cliffanet/car/doc/fwburn/README.md

# Обновление прошивки

Неодходимое оборудование:

- SWD-кабель

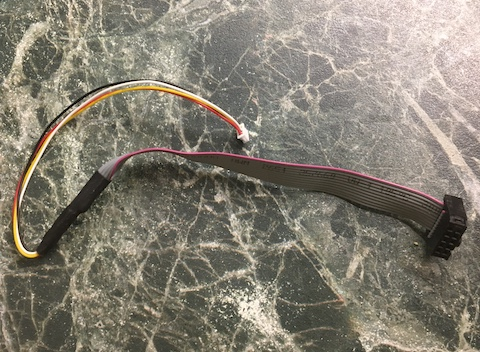
[picture p12: doc/fwburn/swd.cable.jpg]
    

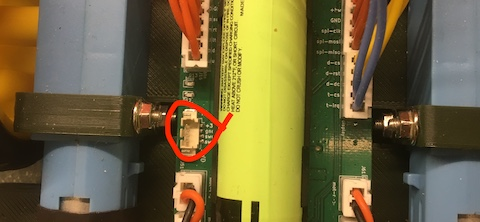
[picture p13: doc/fwburn/swd.port.jpg]
    

- программатор ST-Link v.2

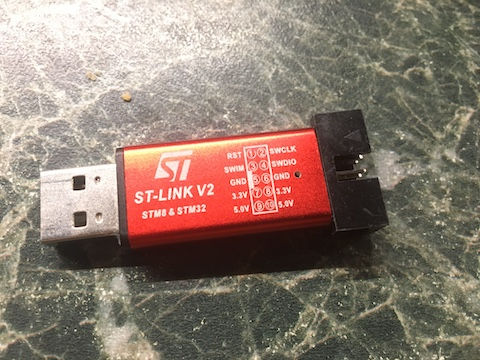
[picture p14: doc/fwburn/stlink.jpg]
    

- [Утилита взаимодействия по SWD-порту](https://www.st.com/en/development-tools/stm32cubeprog.html)
