cliffanet/car/model/bolt.md

# Крепёж

- саморез 2.9х6.5 = 12шт

    - крепление дисплея = 4шт
    - крепления блока кнопок = 4шт
    - крепление платы управления = 4шт

- саморез 2.9х9.5 или 2.9х13 = 6шт

    - крепление кусова к шасси = 6шт

- саморез 2.5х6 (или 2.5х10 с обточенным остриём) с потайной г.

    - нижнее крепление хомутов моторов = 8шт

        Если применять более длинный (2.5х10мм), то он упрётся остриём
        в болт (M3 30мм) и приподнимет мотор.

- болт М3 30мм с потайной г.

    - боковое крепление мотора через хомут = 8 шт

- гайка М3 с фланцем

    - боковое крепление мотора через хомут = 8 шт

- болт M3 12мм

    - [необязательно] крепление хвоста мотора = 4шт

- гайка M3

    - [необязательно] крепление хвоста мотора = 4шт
