cliffanet/car/hw/car.v1.0.jpg

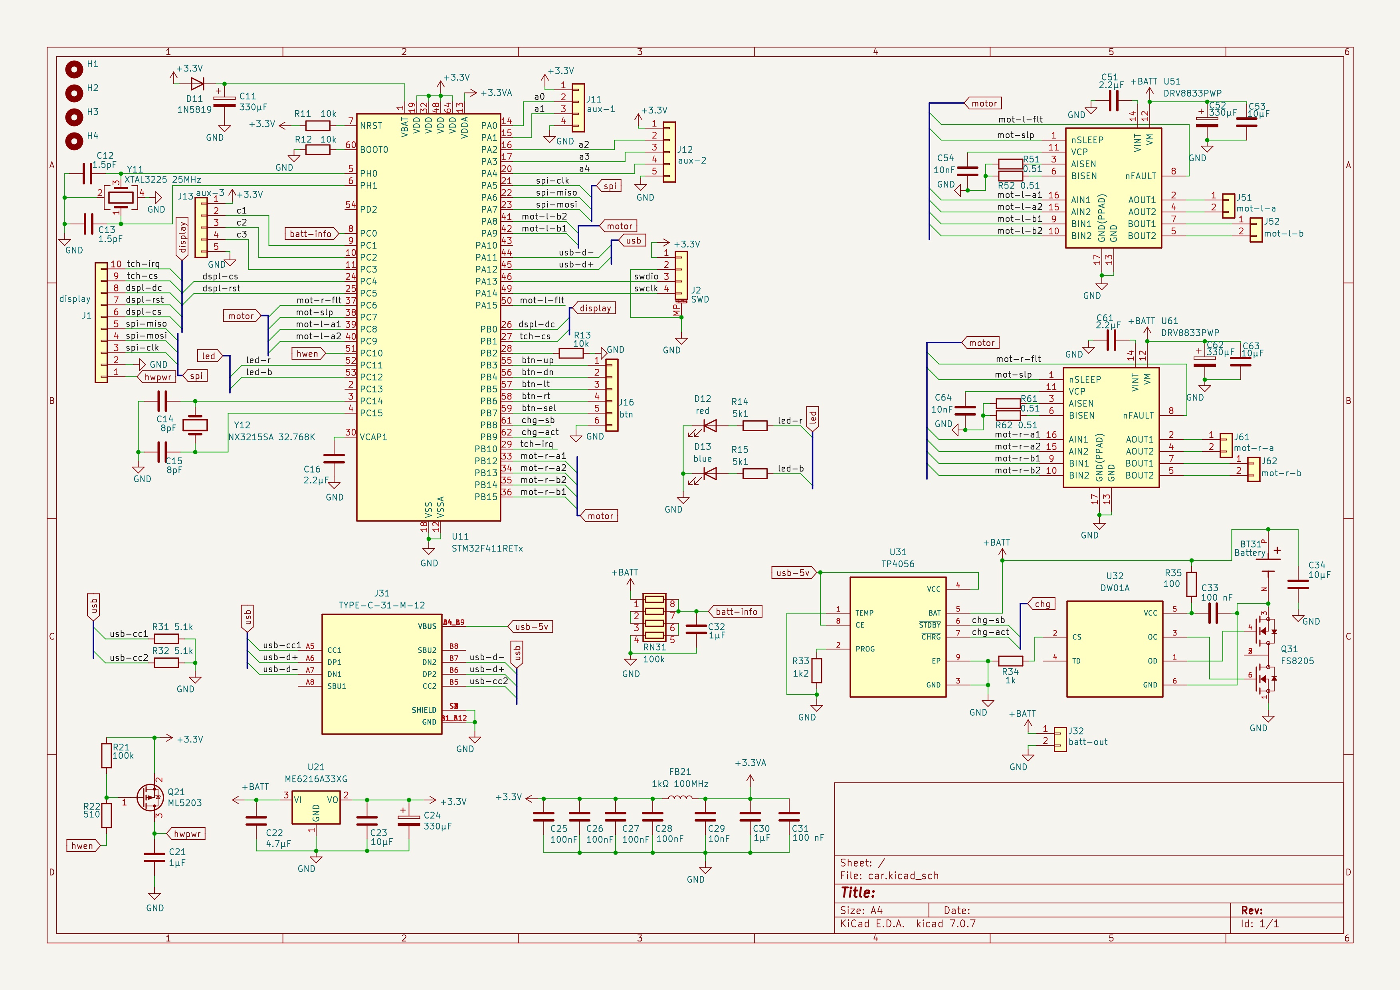
hw/car.v1.0.jpg
