cliffanet/car/hw/footprint/1042/1042.step

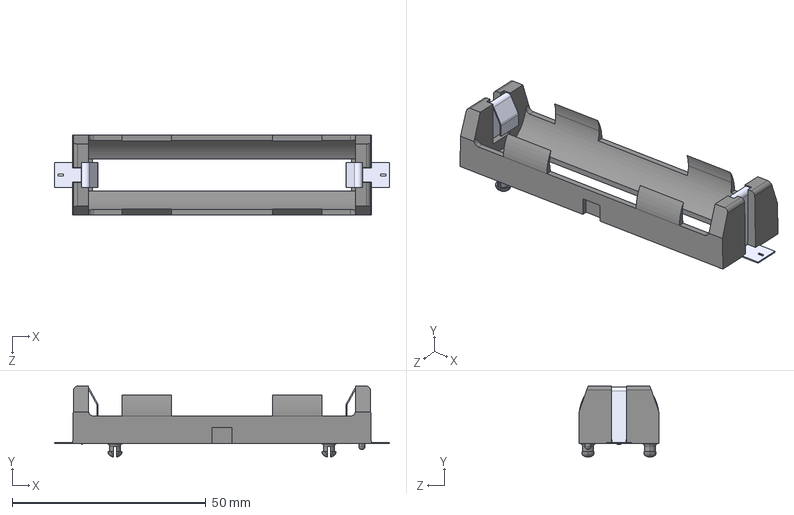
[picture p16: CAD file, 2024-12-18]
hw/footprint/1042/1042.step
86.5 x 18.3 x 20.7 mm
