cliffanet/car/hw/footprint/DW01A/DW01A.step

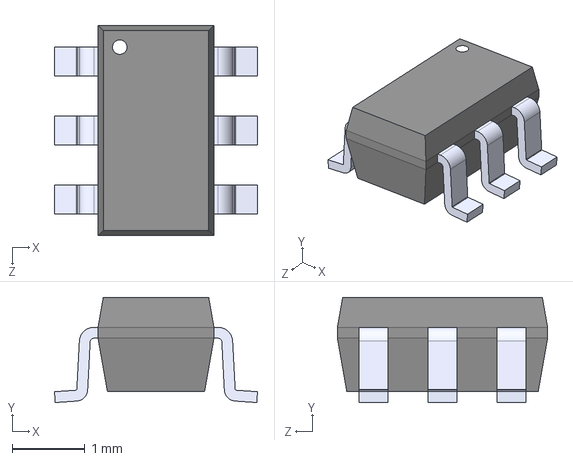
[picture p17: CAD file, 2024-12-18]
hw/footprint/DW01A/DW01A.step
2.80 x 1.45 x 2.90 mm
