cliffanet/car/hw/footprint/FS8205/FS8205.step

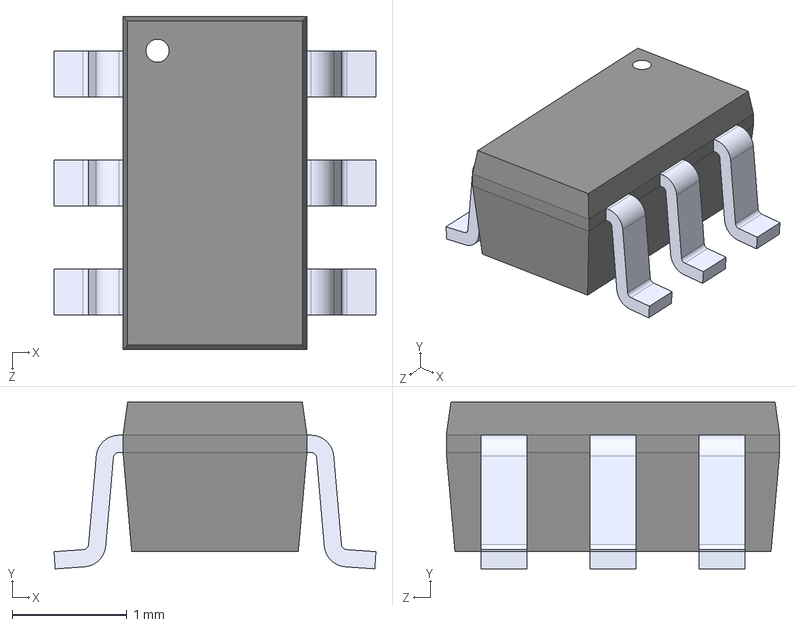
[picture p18: CAD file, 2024-12-18]
hw/footprint/FS8205/FS8205.step
2.80 x 1.45 x 2.90 mm
