cliffanet/car/hw/footprint/NX3215SA-32.768K-STD-MUA-14/NX3215SA-32.768K-STD-MUA-14.step

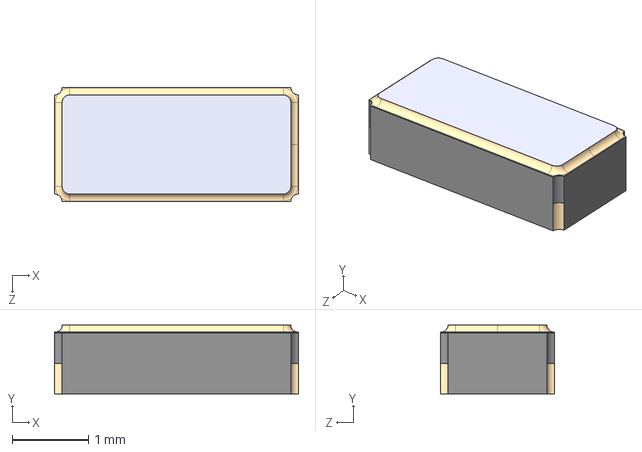
[picture p19: CAD file, 2024-12-18]
hw/footprint/NX3215SA-32.768K-STD-MUA-14/NX3215SA-32.768K-STD-MUA-14.step
3.20 x 0.9 x 1.50 mm
