cliffanet/car/hw/footprint/TP4056/TP4056.step

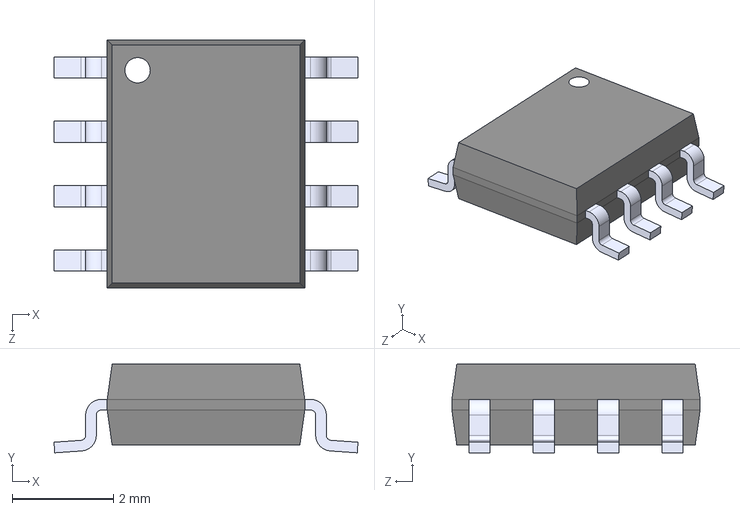
[picture p20: CAD file, 2024-12-18]
hw/footprint/TP4056/TP4056.step
6.00 x 1.75 x 4.90 mm
