cliffanet/car/hw/footprint/TSX-3225_16.0000MF18X-AC3/TSX-3225_16.0000MF18X-AC3.step

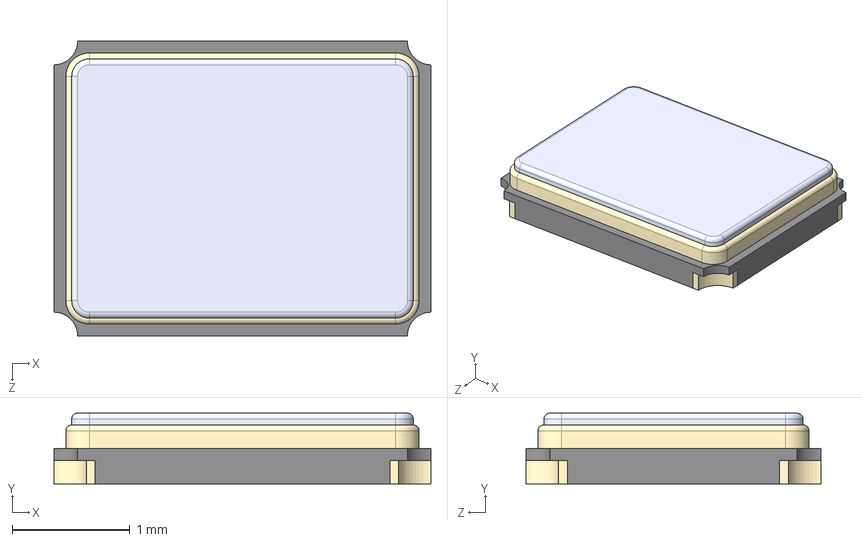
[picture p21: CAD file, 2024-12-18]
hw/footprint/TSX-3225_16.0000MF18X-AC3/TSX-3225_16.0000MF18X-AC3.step
3.20 x 0.6 x 2.50 mm
