cliffanet/car/hw/footprint/TYPE-C-31-M-12/TYPE-C-31-M-12.step

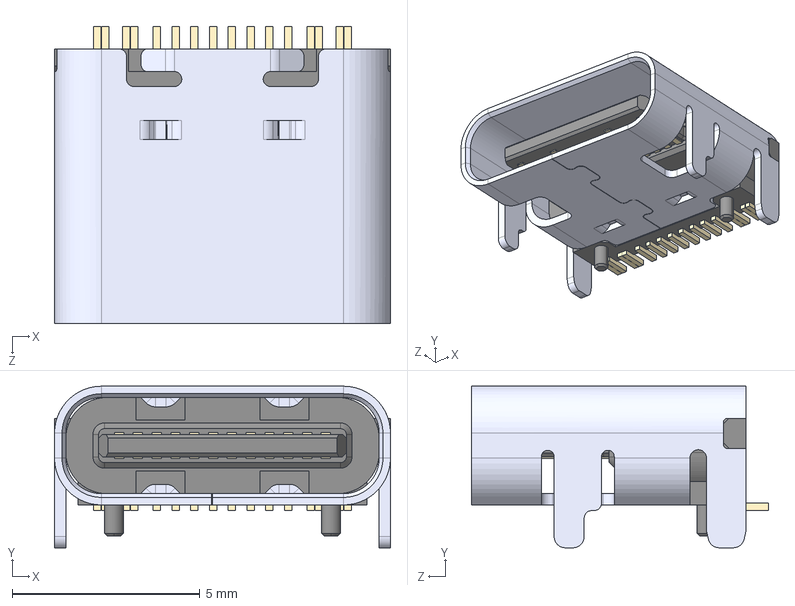
[picture p22: CAD file, 2024-12-18]
hw/footprint/TYPE-C-31-M-12/TYPE-C-31-M-12.step
8.94 x 4.30 x 7.90 mm
