cliffanet/car/model/car-cabine.stl

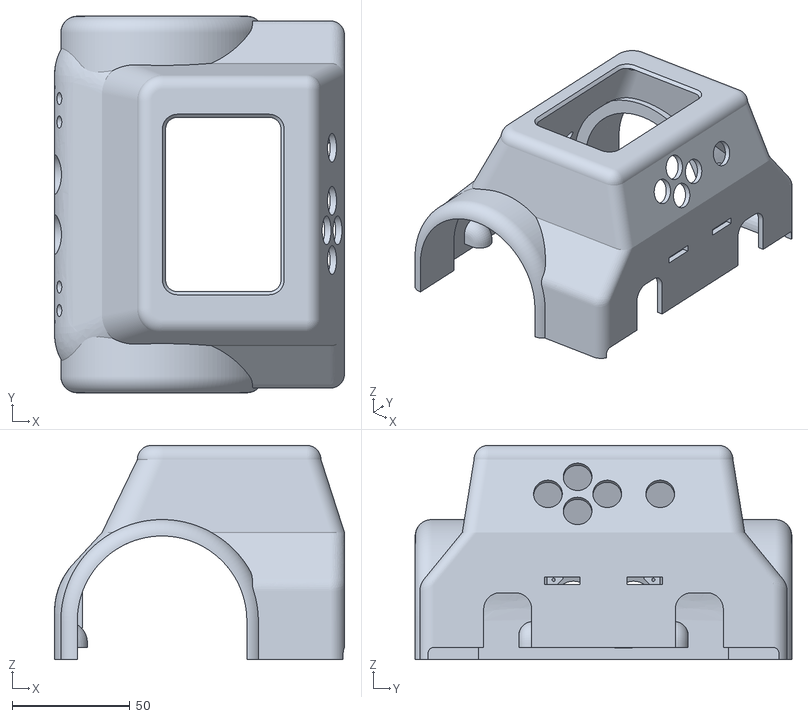
[picture p23: CAD file, 2025-04-08]
model/car-cabine.stl
123.2 x 160.0 x 91.0
