cliffanet/car/model/car-chassis.stl

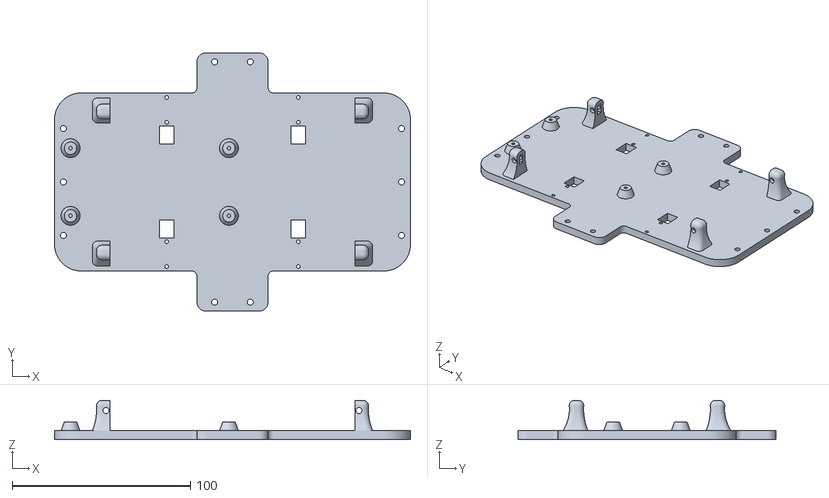
[picture p24: CAD file, 2024-12-19]
model/car-chassis.stl
200.0 x 145.0 x 22.0
