cliffanet/car/model/car-motoclip.stl

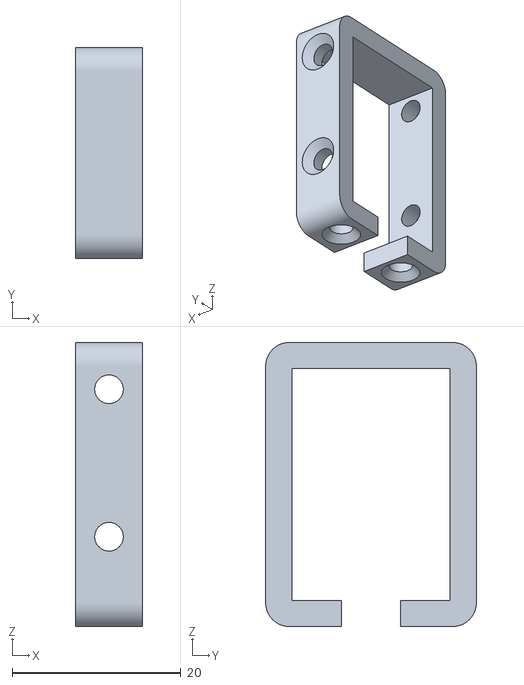
[picture p25: CAD file, 2024-12-19]
model/car-motoclip.stl
8.00 x 25.0 x 33.7
