cliffanet/car/model/car.FCStd

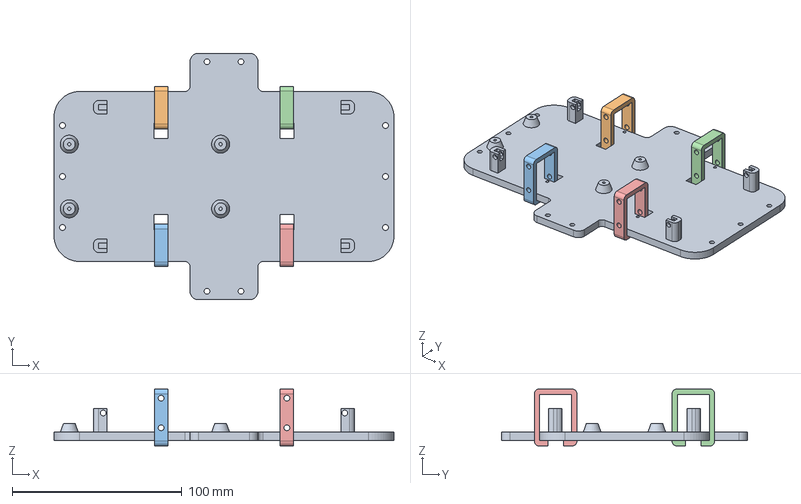
[picture p26: CAD file, 2024-12-14]
model/car.FCStd
200.0 x 145.0 x 33.5 mm
chassis
motoclip
motoclip001
motoclip002
motoclip003
