cliffanet/car/hw/v1.0/car.kicad_pcb

## KiCad design hw/v1.0/car.kicad_pcb (2024-12-19)

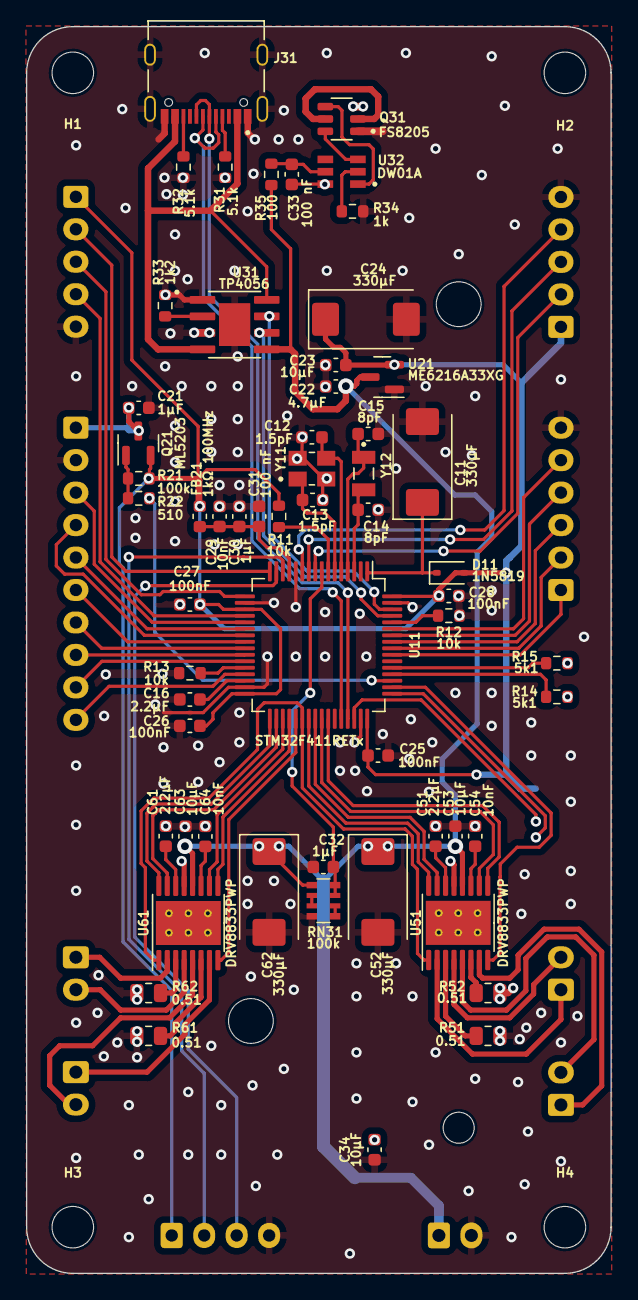
[picture p27: board car.kicad_pcb from above]

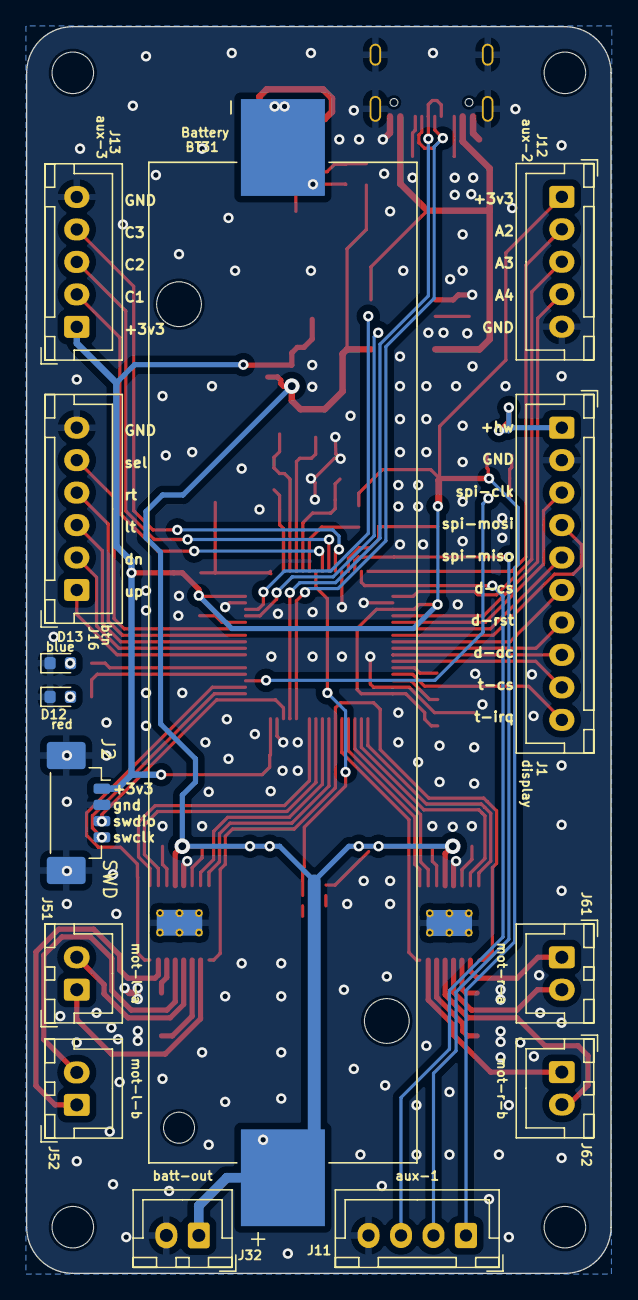
[picture p28: board car.kicad_pcb from below]

Board: 2 copper layers, 45.0 x 96.0 mm, 76 parts (14 on the bottom side), 87 nets.

Parts:
BT31: Battery; BAT_1042
C11, C24, C52, C62: 330μF; CP_EIA-7343-20_Kemet-V
C12, C13: 1.5pF; C_0603_1608Metric
C14, C15: 8pF; C_0603_1608Metric
C16, C51, C61: 2.2μF; C_0603_1608Metric
C21, C30, C32: 1μF; C_0603_1608Metric
C22: 4.7μF; C_0603_1608Metric
C23, C34, C53, C63: 10μF; C_0603_1608Metric
C25, C26, C27, C28: 100nF; C_0603_1608Metric
C29, C54, C64: 10nF; C_0603_1608Metric
C31, C33: 100 nF; C_0603_1608Metric
D11: 1N5819; D_SOD-323
D12: red; LED_0603_1608Metric
D13: blue; LED_0603_1608Metric
FB21: 1kΩ 100MHz; L_0603_1608Metric
H1, H2, H3, H4: MountingHole; MountingHole_3.2mm_M3
J1: display; JST_XH_B10B-XH-A_1x10_P2.50mm_Vertical
J2: SWD; Molex_PicoBlade_53398-0471_1x04-1MP_P1.25mm_Vertical
J11: aux-1; JST_XH_B4B-XH-A_1x04_P2.50mm_Vertical
J12: aux-2; JST_XH_B5B-XH-A_1x05_P2.50mm_Vertical
J13: aux-3; JST_XH_B5B-XH-A_1x05_P2.50mm_Vertical
J16: btn; JST_XH_B6B-XH-A_1x06_P2.50mm_Vertical
J31: TYPE-C-31-M-12; HRO_TYPE-C-31-M-12
J32: batt-out; JST_XH_B2B-XH-A_1x02_P2.50mm_Vertical
J51: mot-l-a; JST_XH_B2B-XH-A_1x02_P2.50mm_Vertical
J52: mot-l-b; JST_XH_B2B-XH-A_1x02_P2.50mm_Vertical
J61: mot-r-a; JST_XH_B2B-XH-A_1x02_P2.50mm_Vertical
J62: mot-r-b; JST_XH_B2B-XH-A_1x02_P2.50mm_Vertical
Q21: ML5203; SOT-23
Q31: FS8205; SOT95P280X145-6N
R11, R12, R13: 10k; R_0603_1608Metric
R14, R15: 5k1; R_0603_1608Metric
R21: 100k; R_0603_1608Metric
R22: 510; R_0603_1608Metric
R31, R32: 5.1k; R_0603_1608Metric
R33: 1k2; R_0603_1608Metric
R34: 1k; R_0603_1608Metric
R35: 100; R_0603_1608Metric
R51, R52, R61, R62: 0.51; R_0805_2012Metric
RN31: 100k; R_Array_Convex_4x0603
U11: STM32F411RETx; LQFP-64_10x10mm_P0.5mm
U21: ME6216A33XG; SOT-23
U31: TP4056; SOP127P600X175-9N
U32: DW01A; SOT95P280X145-6N
U51, U61: DRV8833PWP; HTSSOP-16-1EP_4.4x5mm_P0.65mm_EP3.4x5mm_Mask2.46x2.31mm_The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
Y11: XTAL3225 25MHz; XTAL_TSX-3225_16.0000MF18X-AC3
Y12: NX3215SA 32.768K; XTAL_NX3215SA-32.768K-STD-MUA-14

Connections:
+3.3VA: C29.2, C30.2, C31.2, FB21.2, U11.13 (VDDA)
+3V3: C23.1, C24.1, C25.1, C26.1, C27.1, C28.2, D11.2 (A), FB21.1, J2.1, J11.1, J12.1, J13.1, Q21.2 (S), R11.1, R21.2, U11.19 (VDD), U11.32 (VDD), U11.48 (VDD), U11.64 (VDD), U21.2 (VO)
+BATT: BT31.P, C22.1, C34.1, C52.1, C53.1, C62.1, C63.1, J32.1, R35.2, RN31.1 (R1.1), U21.3 (VI), U31.5 (BAT), U51.12 (VM), U61.12 (VM)
/a0: J11.2, U11.14 (PA0)
/a1: J11.3, U11.15 (PA1)
/a2: J12.2, U11.16 (PA2)
/a3: J12.3, U11.17 (PA3)
/a4: J12.4, U11.20 (PA4)
/btn-dn: J16.2, U11.56 (PB4)
/btn-lt: J16.3, U11.57 (PB5)
/btn-rt: J16.4, U11.58 (PB6)
/btn-sel: J16.5, U11.59 (PB7)
/btn-up: J16.1, U11.55 (PB3)
/c1: J13.2, U11.9 (PC1)
/c2: J13.3, U11.10 (PC2)
/c3: J13.4, U11.11 (PC3)
/chg-act: U11.62 (PB9), U31.7 (~CHRG)
/chg-sb: U11.61 (PB8), U31.6 (~STDBY)
/dspl-cs: J1.6, U11.24 (PC4)
/dspl-dc: J1.8, U11.26 (PB0)
/dspl-rst: J1.7, U11.25 (PC5)
/led-b: R15.2, U11.53 (PC12)
/led-r: R14.2, U11.52 (PC11)
/mot-l-a1: U11.39 (PC8), U51.16 (AIN1)
/mot-l-a2: U11.40 (PC9), U51.15 (AIN2)
/mot-l-b1: U11.42 (PA9), U51.9 (BIN1)
/mot-l-b2: U11.41 (PA8), U51.10 (BIN2)
/mot-l-flt: U11.50 (PA15), U51.8 (nFAULT)
/mot-r-a1: U11.33 (PB12), U61.16 (AIN1)
/mot-r-a2: U11.34 (PB13), U61.15 (AIN2)
/mot-r-b1: U11.36 (PB15), U61.9 (BIN1)
/mot-r-b2: U11.35 (PB14), U61.10 (BIN2)
/mot-r-flt: U11.37 (PC6), U61.8 (nFAULT)
/mot-slp: U11.38 (PC7), U51.1 (nSLEEP), U61.1 (nSLEEP)
/spi-clk: J1.3, U11.21 (PA5)
/spi-miso: J1.5, U11.22 (PA6)
/spi-mosi: J1.4, U11.23 (PA7)
/swclk: J2.4, U11.49 (PA14)
/swdio: J2.3, U11.46 (PA13)
/tch-cs: J1.9, U11.27 (PB1)
/tch-irq: J1.10, U11.29 (PB10)
/usb-cc1: J31.A5 (CC1), R31.2
/usb-cc2: J31.B5 (CC2), R32.2
/usb-d+: J31.A6 (DP1), J31.B6 (DP2), U11.45 (PA12)
/usb-d-: J31.A7 (DN1), J31.B7 (DN2), U11.44 (PA11)
GND: C11.2, C12.1, C13.2, C14.1, C15.1, C16.2, C21.2, C22.2, C23.2, C24.2, C25.2, C26.2, C27.2, C28.1, C29.1, C30.1, C31.1, C32.1, C34.2, C51.2, C52.2, C53.2, C54.2, C61.2, C62.2, C63.2, C64.2, D12.1 (K), D13.1 (K), J1.2, J2.2, J2.MP (MountPin), J11.4, J12.5, J13.5, J16.6, J31.A1_B12 (GND), J31.B1_A12 (GND), J31.S1 (SHIELD), J31.S2 (SHIELD), J31.S3 (SHIELD), J31.S4 (SHIELD), J32.2, Q31.1, R12.1, R13.2, R31.1, R32.1, R33.2, R34.2, R51.1, R52.1, R61.1, R62.1, RN31.4 (R4.1), U11.12 (VSSA), U11.18 (VSS), U11.31 (VSS), U11.47 (VSS), U11.63 (VSS), U21.1 (GND), U31.1 (TEMP), U31.3 (GND), U31.9 (EP), U51.13 (GND), U51.17 (GND(PPAD)), U61.13 (GND), U61.17 (GND(PPAD)), Y11.2, Y11.4
unnamed: C11.1, D11.1 (K), U11.1 (VBAT)
unnamed: D12.2 (A), R14.1
unnamed: D13.2 (A), R15.1
unnamed: J51.1, U51.2 (AOUT1)
unnamed: J51.2, U51.4 (AOUT2)
unnamed: J52.1, U51.7 (BOUT1)
unnamed: J52.2, U51.5 (BOUT2)
unnamed: J61.1, U61.2 (AOUT1)
unnamed: J61.2, U61.4 (AOUT2)
unnamed: J62.1, U61.7 (BOUT1)
unnamed: J62.2, U61.5 (BOUT2)
unnamed: Q21.1 (G), R21.1, R22.1
unnamed: Q31.2, Q31.5
unnamed: RN31.2 (R2.1), RN31.3 (R3.1)
unnamed: RN31.5 (R4.2), RN31.6 (R3.2)
unnamed: R12.2, U11.60 (BOOT0)
unnamed: R11.2, U11.7 (NRST)
unnamed: R13.1, U11.28 (PB2)
unnamed: C14.2, U11.3 (PC14), Y12.2
unnamed: C15.2, U11.4 (PC15), Y12.1
unnamed: C12.2, U11.5 (PH0), Y11.3
unnamed: C13.1, U11.6 (PH1), Y11.1
unnamed: C16.1, U11.30 (VCAP1)
unnamed: R33.1, U31.2 (PROG)
unnamed: R34.1, U32.2 (CS)
unnamed: BT31.N, C33.2, Q31.3, U32.6 (GND)
unnamed: Q31.6, U32.3 (OC)
unnamed: Q31.4, U32.1 (OD)
unnamed: C33.1, R35.1, U32.5 (VCC)
unnamed: R51.2, U51.3 (AISEN)
unnamed: R52.2, U51.6 (BISEN)
unnamed: C54.1, U51.11 (VCP)
unnamed: C51.1, U51.14 (VINT)
unnamed: R61.2, U61.3 (AISEN)
unnamed: R62.2, U61.6 (BISEN)
unnamed: C64.1, U61.11 (VCP)
unnamed: C61.1, U61.14 (VINT)
batt-info: C32.2, RN31.7 (R2.2), RN31.8 (R1.2), U11.8 (PC0)
hwen: R22.2, U11.51 (PC10)
hwpwr: C21.1, J1.1, Q21.3 (D)
usb-5v: J31.A4_B9 (VBUS), J31.B4_A9 (VBUS), U31.4 (VCC), U31.8 (CE)
