cliffanet/car/cube/car.stm32f401ret.ioc

Mcu.UserName=STM32F401RETx
PA11.Signal=USB_OTG_FS_DM
PA12.Signal=USB_OTG_FS_DP
PA15.GPIO_Label=mot-l-flt
PA15.Signal=GPIO_Input
PA2.GPIO_Label=sr04 echo
PA2.Signal=GPXTI2
PA3.GPIO_Label=sr04 trig
PA3.Signal=S_TIM2_CH4
PA5.Signal=SPI1_SCK
PA6.Signal=SPI1_MISO
PA7.Signal=SPI1_MOSI
PA8.GPIO_Label=mot-l-b2
PA8.Signal=GPIO_Output
PA9.GPIO_Label=mot-l-b1
PA9.Signal=GPIO_Output
PB0.GPIO_Label=dspl-dc
PB0.Signal=GPIO_Output
PB1.GPIO_Label=touch-cs
PB1.Signal=GPIO_Output
PB10.GPIO_Label=touch-irq
PB10.Signal=GPXTI10
PB12.GPIO_Label=mot-r-a1
PB12.Signal=GPIO_Output
PB13.GPIO_Label=mot-r-a2
PB13.Signal=GPIO_Output
PB14.GPIO_Label=mot-r-b2
PB14.Signal=GPIO_Output
PB15.GPIO_Label=mot-r-b1
PB15.Signal=GPIO_Output
PB3.GPIO_Label=btn-up
PB3.Signal=GPXTI3
PB4.GPIO_Label=btn-dn
PB4.Signal=GPXTI4
PB5.GPIO_Label=btn-lt
PB5.Signal=GPXTI5
PB6.GPIO_Label=btn-rt
PB6.Signal=GPXTI6
PB7.GPIO_Label=btn-sel
PB7.Signal=GPXTI7
PB8.GPIO_Label=batt-chg-stb
PB8.Signal=GPIO_Input
PB9.GPIO_Label=batt-chg-act
PB9.Signal=GPIO_Input
PC0.GPIO_Label=batt-info
PC0.Signal=ADCx_IN10
PC1.GPIO_Label=aux-3-c1
PC1.Signal=GPIO_Output
PC10.GPIO_Label=hwen
PC10.Signal=GPIO_Output
PC11.GPIO_Label=led-red
PC11.Signal=GPIO_Output
PC12.GPIO_Label=led-blue
PC12.Signal=GPIO_Output
PC14-OSC32_IN.Signal=RCC_OSC32_IN
PC15-OSC32_OUT.Signal=RCC_OSC32_OUT
PC2.GPIO_Label=aux-3-c2
PC2.Signal=GPIO_Output
PC3.GPIO_Label=aux3-c3
PC3.Signal=GPIO_Output
PC4.GPIO_Label=dspl-cs
PC4.Signal=GPIO_Output
PC5.GPIO_Label=dspl-rst
PC5.Signal=GPIO_Output
PC6.GPIO_Label=mot-r-flt
PC6.Signal=GPIO_Input
PC7.GPIO_Label=mot-sleep
PC7.Signal=GPIO_Output
PC8.GPIO_Label=mot-l-a1
PC8.Signal=GPIO_Output
PC9.GPIO_Label=mot-l-a2
PC9.Signal=GPIO_Output
