cliffanet/car/cube/source/sys/proc.cpp

#include "proc.h"
#include "stm32drv.h"
#include "log.h"

#include <list>

static std::list<proc::el_t> _proc;

void init_power();
void init_display();
void init_touch();
void init_btn();
void init_batt();
void init_motor();
void init_path();
void init_sr04();

extern "C"
void init() {
    init_power();
    init_display();
    init_touch();
    init_btn();
    init_batt();
    init_motor();
    init_path();
    init_sr04();

    while (1) {
        for (auto p: _proc)
            p();
    }
}


extern "C"
void sr04_byexti(uint16_t pin);
extern "C"
void btn_byexti(uint16_t pin);

extern "C"
void HAL_GPIO_EXTI_Callback(uint16_t GPIO_Pin) {
    /*
    uint8_t l = HAL_GPIO_ReadPin(TOUCH_PIN_IRQ);
        CONSOLE("touch: %d", l);

    if ((GPIO_Pin == GPIO_PIN_10) && !l) {
        tcupd = true;
    }
    */

    sr04_byexti(GPIO_Pin);
    btn_byexti(GPIO_Pin);
}

/*
extern "C"
void HardFault_Handler(void) {
    while (1) {
        for (int n = 0; n < 3000000; n++)
            asm("");
        HAL_GPIO_TogglePin(GPIOA, led_red_Pin);
    }
}

extern "C"
void MemManage_Handler(void) {
    while (1) {
        for (int i =0; i < 10; i++) {
            for (int n = 0; n < 3000000; n++)
                asm("");
            HAL_GPIO_TogglePin(GPIOA, led_red_Pin);
        }
        for (int n = 0; n < 30000000; n++)
            asm("");
    }
}
*/

namespace proc {
    void add(el_t p) {
        for (const auto e: _proc)
            if (p == e)
                return;
        _proc.push_back(p);
    }

    void del(el_t p) {
        for (auto i = _proc.cbegin(); i != _proc.cend(); i++)
            if (*i == p) {
                _proc.erase(i);
                return;
            }
    }
};
