cliffanet/car/cube/source/sys/batt.h

/*
    Batt
*/

#ifndef _sys_batt_H
#define _sys_batt_H

#include "../def.h"
#include <stdint.h>


namespace batt {

    uint16_t raw();
    uint8_t val05();
    bool charge();

} // namespace batt 

#endif // _sys_batt_H
