cliffanet/car/(commit log)

2024-12-13 модель - шасси и крепления мотора
    [car.FCStd]
2024-12-14 модель - доработки под плату
    [car.FCStd]
2024-12-18 печатная плата - осталось только доделать надписи разъёмов и перепроверить
    [1042.step, DRV8833PWPR.step, DW01A.step, FS8205.step, NX3215SA-32.768K-STD-MUA-14.step, TP4056.step, TSX-3225_16.0000MF18X-AC3.step, TYPE-C-31-M-12.step]
2024-12-18 модель - описание необходимых болтов
2024-12-19 плата - надписи
    [car.kicad_pcb, car.kicad_sch]
2024-12-19 модель - доработки шасси и креплений мотора
    [car-chassis.stl, car-motoclip.stl]
2025-01-02 модель - кабина
    [car-cabine.stl]
2025-01-02 плата - архив v1
    [car.kicad_pcb, car.kicad_sch]
2025-01-02 fw - заготовка
2025-01-12 модель - кабина - небольшие баги и доработки
    [car-cabine.stl]
2025-01-12 fw - реорганизация кода
2025-01-15 дисплей - драйвер аппаратной части + заготовка под gfx
2025-01-16 дисплей - двойной буфер для ускорения вывода
2025-01-16 дисплей gfx - прямоугольники
2025-01-17 дисплей - небольшой рефакторинг классов
2025-01-18 дисплей gfx - окружность и скруглённые прямоугольники
2025-01-18 дисплей - функции по преобразованию цветов
2025-01-20 тачскрин
2025-01-20 реорганизация кода основнога процессинга
2025-01-22 дисплей - вывод текста, шрифты u8g2
2025-02-01 работа кнопок, перешли пинами на свою плату
2025-02-02 модули управления светодиодами и моторами
2025-02-02 контроль заряда батареи
2025-02-02 дисплей - перевернули на 180
2025-02-02 моторы - команды управления всеми двигателями сразу
2025-02-03 управление питанием
2025-02-03 движение по нарисованному маршруту
2025-02-10 небольшие доработки
2025-02-10 документация - крепёж
2025-02-10 документация
2025-02-11 плата - небольшие правки
    [car.kicad_pcb]
2025-02-12 документация - изготовление платы, программирование, фото/видео
2025-04-06 модель кузова - крепление под уз датчик расстояния
    [car-cabine.stl]
2025-04-06 дальномер - средство объезда препятствий
2025-04-08 3д кабина - уз датчик препятствий
    [car-cabine.stl]
2025-04-08 баг из-за повторного использования exti3
